KarenGhardashyan/scissor-mechanism-golden-rule/paper/main.pdf

## Beyond the Ideal Pantograph: A Hands-On and Computational

## Framework for Exploring Scissor Mechanism Dynamics and the Golden

## Rule of Mechanics

Karen Ghardashyan¹

, Bilor Kourghinyan¹

1A. Shahinyan Special Phys-Math School under Yerevan State University, Yerevan, Armenia

Project Repository: https://github.com/karenghardashyan/scissor-mechanism-golden-rule

Interactive 3D Digital Twin: https://karenghardashyan.github.io/scissor-mechanism-golden-rule/

October 2026

Abstract

The Golden Rule of Mechanics (Goldene Regel der Mechanik) and the Principle of Virtual Work represent the conceptual bedrock of classical conservative mechanics, yet in secondary and introductory university physics, they are predominantly taught through static, idealized, single-degree-of-freedom abstractions (such as frictionless levers or massless pulleys). Consequently, students rarely encounter the non-trivial physical complexities that emerge when kinematic transmission is embodied in real mechanical hardware. This paper presents an end-to-end experimental, analytical, and computational framework investigating multi-stage scissor pantograph linkages. Utilizing parametric Computer-Aided Design (SolidWorks) and high-precision Additive Manufacturing (FFF 3D printing in Polylactic Acid), three physical testbenches were fabricated: uniform n = 3 stages (Rig A), uniform n = 5 stages (Rig B), and a novel geometrically progressive 1 : 2 : 3 scaling cascade (Rig C). Laboratory load testing (m ∈ [0.00 kg, 1.15 kg]) verified theoretical displacement amplification factors with high fidelity (λA = 3.04 ± 0.10 for n = 3, and λB = 4.94 ± 0.12 for n = 5). Furthermore, analytical derivations accounting for distributed linkage self-weight were experimentally corroborated, extracting effective Hookean spring constants (kn=3 ≈ 981 N/m, kn=5 ≈ 1090 N/m). Tests with hyperelastic latex polymers revealed that while force-displacement curves exhibited marked 3rd-order polynomial non-linearity, the geometric displacement transmission ratio remained strictly invariant (λ = 4.96 ≈ 5.0). Manufacturing constraints—specifically desktop 3D printer build plate limits and joint clearance tolerances (≈ 0.15 mm)—are evaluated alongside Coulomb joint friction hysteresis (±1.5 mm). Finally, the physical rigs are mirrored in an open-source, web-deployed 3D Digital Twin built in Godot Engine 4.5, powered by a 400 Hz sub-stepped Velocity Verlet symplectic numerical integrator. This combined framework provides a powerful template for Maker-driven physics education and deployable structural engineering.

### 1. Introduction & Pedagogical Motiva-

tion

A foundational tenet of classical mechanics is the Golden Rule of Mechanics (Goldene Regel der Mechanik), historically traceable to Heron of Alexandria and formalized by Galileo Galilei in Le Mecaniche (1593) [1]:

“What is gained in force is lost in distance, and what is gained in distance is lost in force.”

In formal analytical mechanics, this insight is codified through the Principle of Virtual Work, which states that for any static system in mechanical equilibrium, the total virtual work done by external and internal forces during infinitesimal reversible virtual displacements is zero (δW = 0) [2, 3].
Despite the universality of this principle, a persistent pedagogical gap exists in secondary and undergraduate physics curricula. Mechanical advantage is routinely introduced through one-dimensional textbook diagrams— ideal levers, frictionless inclined planes, or massless pulleys [4]. While mathematically accessible, these simplistic paradigms fail to confront students with the physical realities encountered in real mechanical systems:
1. Coupled Multistage Kinematics: The relationship between local input deformation and global output stroke across cascaded geometric linkages.
2. Distributed | Structural | Mass: | The non-
negligible self-weight of structural members, which alters static equilibrium and shifts the line of action.
3. Frictional and Viscoelastic Dissipation: Non-conservative Coulomb sliding friction at pin joints, contact hysteresis, and non-Hookean material non-linearities [5].

4. Manufacturing Tolerances & Design Constraints: Mechanical backlash, pin clearance, and spatial build-volume boundaries during digital fabrication [6].

To bridge this divide, this research project adopts a comprehensive Sim-to-Real methodology. Originally initiated as a high school experimental laboratory project at the A. Shahinyan Special Phys-Math School under Yerevan State University (YSU) [7], the investigation has evolved across a two-year research trajectory into an integrated hardware-software framework:

- Parametric CAD & DFM: Linkages engineered in SolidWorks and manufactured via fused filament fabrication (FFF) 3D printing in Ultimaker Cura [8, 9].
- Empirical Metrology: Systematic load testing across multiple kinematic configurations, validating displacement amplification ratios and extracting spring constants.
- Mathematical Rigor: Exact analytical formulations compensating for linkage self-weight and polymer hyperelasticity.
- Computational Digital Twin: A real-time 3D simulation bench developed in Godot Engine 4.5 [10, 11], featuring a 400 Hz Velocity Verlet symplectic numerical solver and dynamic telemetry, deployed freely on the web [12].

### 2. Theoretical Mechanics & Formulations

### 2.1. Virtual Work in Ideal Scissor Linkages

Consider a multi-stage pantograph linkage consisting of n identical interconnected rhombic stages, suspended vertically from an upper fixed gantry mount (Fig. 1). Each rhombus is formed by four rigid links of length l, pinned at their vertices and intersecting midpoints.
Let θ denote the kinematic scissor angle between the links and the horizontal axis. For a single rhombic stage i, the instantaneous vertical diagonal height hi(θ) and horizontal transverse span wi(θ) are given by:
hi(θ) = 2lsin θ, | wi(θ) = 2l cos θ | (1)

The total vertical span L(θ) of a uniform linkage containing n identical stages stacked in series is:

L(θ) = ∑n

i=1

hi(θ) = n · h(θ) = 2nlsin θ | (2)

Now let an elastic tension element (a steel coil spring) be attached across the vertical diagonal of the top rhombic stage, exerting an internal contractile tension force T across displacement H ≡ h1. A suspended load mass

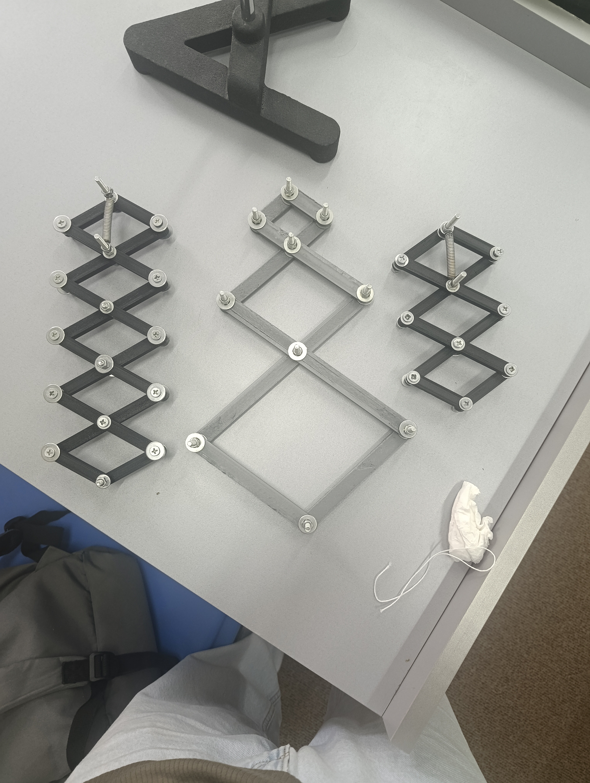
[picture p17: figure]

Figure 1: The Physical Apparatus Trio: Comparative laboratory overview of the three engineered 3D-printed scissor linkages resting on the test bench. Left: Mechanism B (n = 5 uniform stages). Center: Mechanism C (1 : 2 : 3 geometric cascade). Right: Mechanism A (n = 3 uniform stages). All configurations share an identical modular suspension anchor and internal tension spring mounting interface.

m exerts a downward gravitational force P = mg at the lowest terminal hinge.
Applying the Principle of Virtual Work to a virtual displacement δθ:
δW = δWin − δWout = 0 | (3)

where δWin = T · δH is the virtual work performed by the internal tension spring as the top stage compresses/extends by δH, and δWout = P ·δL is the virtual work done on the suspended payload over the total mechanism stroke δL.
Differentiating Eq. (2) with respect to H:

δL
δH =

n · δH
δH | = n ≡ λ | (4)

where λ represents the non-dimensional kinematic transmission ratio (displacement amplification factor). Substituting Eq. (4) into the virtual work equilibrium:

T · δH = P · (n · δH) =⇒ T = n · P | (5)

Equation (5) represents the ideal Golden Rule of Mechanics for the scissor pantograph: the mechanism achieves an n-fold amplification in linear stroke at the expense of requiring an n-fold greater contractile tension force at the input stage.

### 2.2. Self-Weight Gravitational Correction

In any physical apparatus, the structural mass of the 3D-printed plastic linkages cannot be neglected. Standard textbook treatments treat linkages as massless lines, leading to significant systematic discrepancies between theory and experimental measurements.
Let mlink denote the mass of a single cross-arm. Each rhombic stage consists of two full overlapping cross-bars (or four perimeter links), yielding an effective mass per stage of:
mstage ≈ 2mlink | (6)

The total structural weight of an n-stage pantograph is Pw = n · mstage · g.
Because the linkage is distributed along the vertical coordinate z, each individual stage i (indexed from top i = 1 to bottom i = n) possesses a local center of mass located at:

zi =

(
i −

1
2

)
H | (7)

The total gravitational potential energy Ulinks stored in the linkage assembly is the sum over all n stages:

Ulinks =

∑n

i=1

mstagegzi

= mstagegH ∑n

i=1

(
i −

1
2

)

= mstagegH [
n(n + 1)
2

−

n
2

]

= mstagegH n

2
2

(8)

Recalling that n · mstageg = Pw and nH = L:

Ulinks = Pw

nH
2

= Pw

L
2

(9)

Equation (9) yields an extraordinarily elegant result: the distributed self-weight of the entire multi-stage pantograph acts identically to a single point mass equal to Pw positioned at the exact mid-stroke of the mechanism (Scm = L/2).
Including Ulinks in the work-energy balance:

T · δH = P · δL +

∂Ulinks
∂H δH | (10)

Differentiating Eq. (9) with respect to H:

∂Ulinks
∂H =

nPw
(11)

Hence:
T · δH = P(n · δH) + nPw
2
| | δH | (12)

Dividing through by δH yields the corrected tension equation:

T(P) = n

(
P +

Pw
2

)
⇐⇒ T(m) = n

(
mg +

Pw
2

)

(13)
Equation (13) demonstrates that the self-weight of the scissor arms contributes an invariant baseline equivalent load equal to half the total mechanism weight (Pw/2).

### 2.3. Linear Hookean Static Equilibrium

When the contractile element in the top stage is a linear steel coil spring obeying Hooke’s Law:

T(H) = k · (H − H0) = k · ∆H | (14)

where k is the spring stiffness constant and H0 is the unforced resting height of the top rhombus.
Equating Eq. (14) with Eq. (13):

k · ∆H(m) = n

(
mg +
| | Pw
| | 2

)
(15)

Solving for the top-stage elongation ∆H(m):

∆H(m) = m ·

| (ng
| k

)
| | + nPw 2k
(16)

Similarly, the total span extension L(m) = n · H(m) becomes:

L(m) = nH0 + m ·

(
| n

2
| | g
k

)
| | + n 2Pw
| | 2k

(17)

Equations (16) and (17) show that plotting ∆H or L against suspended load m yields a linear relationship whose slope enables direct experimental extraction of the spring stiffness k:

Slope = tan α =

| ng k
⇐⇒ k =

ng
| | tan α

(18)

### 2.4. The Progressive 1:2:3 Kinematic Cascade

(Mechanism C)

To push the limits of pantograph kinematics beyond uniform stages, a non-uniform progressive scissor linkage was conceived, modeled, and manufactured (Fig. 1, center).
In Mechanism C, each successive tier increases in geometric scale following an arithmetic progression of ratio 1 : 2 : 3:
l1 = l0, | l2 = 2l0, | l3 = 3l0 | (19)

Because the three rhombic stages share coupled angular scissor joints, they maintain an identical angular aperture θ at all stroke positions.

The vertical height of each stage is directly proportional to its link length:

h1 = 2l0 sin θ = H, | h2 = 2H, | h3 = 3H | (20)

The total stroke length LC of the progressive assembly is:
LC = h1 + h2 + h3 = (1 + 2 + 3)H = 6H (21)

Consequently, the kinematic transmission ratio of the
progressive cascade is: λC = | δLC
| δH = 6.00 | | (22)

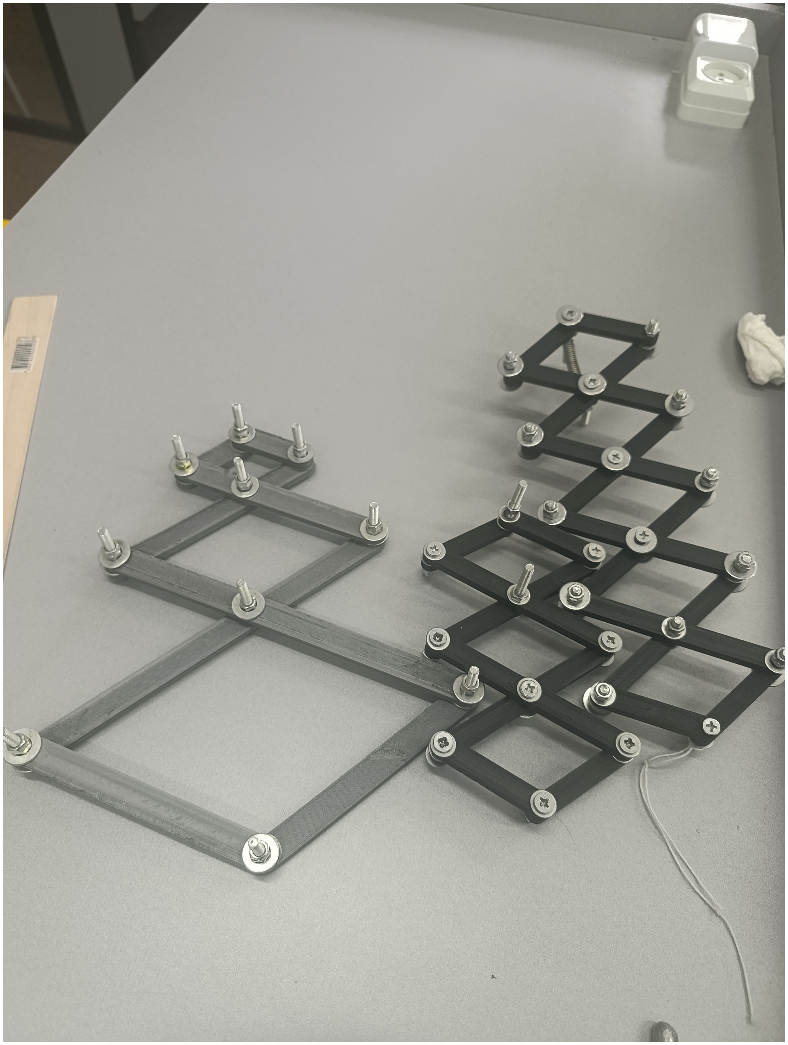
[picture p18: figure]

Figure 2: Progressive vs Uniform Geometry: Topdown comparison between the progressive 1 : 2 : 3 linkage (Mechanism C, left) and the uniform 5-stage linkage (Mechanism B, right). Mechanism C achieves λC = 6 using only 3 stages, but imposes significant transverse footprint expansion and out-of-plane moment demands.

This result is remarkable from an engineering perspective:

- A uniform 5-stage pantograph (Mechanism B) achieves λ = 5 with N = 5 stages.
- The progressive cascade (Mechanism C) achieves λ = 6 with only N = 3 stages.

However, this mechanical amplification comes with profound structural trade-offs. The mass of the links scales proportionally with link length (m1 = m0, m2 = 2m0, m3 = 3m0), producing a non-uniform mass distribution:

Ulinks,C = g

[
m0

(
H
2

)
+ 2m0(2H) + 3m0(4.5H)

]

= gm0H(0.5 + 4.0 + 13.5) = 18m0gH (23)

Since the total mass is MC = (1 + 2 + 3)m0 = 6m0, we obtain:

Ulinks,C = 3MC gH =

1
2
MC gLC | (24)

Thus, the centroid factor remains identically 1/2, while the required input tension scales to:
TC = 6 (
P +

1
2

Pw,C )
(25)

Furthermore, the larger bottom stage links (l3 = 180 mm) experience three times greater bending moments (M ∝ l), increasing lateral compliance and demanding reinforced cross-sectional geometry.

### 2.5. Non-Linear Hyperelasticity (Elastomer For-

mulation)

When the steel spring is replaced by a vulcanized latex rubber polymer, the linear Hookean formulation breaks down. Rubber elasticity originates from entropic changes in tangled macromolecular polymer chains [5]. Under uniaxial tensile strain, the mechanical response traverses three distinct domains:

1. Initial Linear Elasticity: Small strains (ε < 0.2), governed by standard Gaussian network entropy.
2. Conformational Softening: Moderate strains (0.2 < ε < 1.0), where chain uncoiling reduces tangent stiffness.
3. Hyperelastic Hardening: High strains (ε > 1.0), where finite chain extensibility and strain crystallization cause dramatic stiffening.

To capture this non-linear constitutive relationship empirically without loss of kinematic generality, a 3rd-order polynomial regression is formulated:

L(m) = a3m³ + a2m² + a1m + L0 | (26)

where a3, a2, a1 are empirical material coefficients. Crucially, as will be demonstrated in Section V, while L(m) is decidedly non-linear, the ratio λ = L/H remains strictly constant and invariant, affirming that geometric kinematics is decoupled from constitutive material non-linearity.

### 3. Design for Additive Manufacturing

(CAD/CAM)

### 3.1. Parametric Linkage Design in SolidWorks

All physical linkages were modeled parametrically in SolidWorks 2024 (Fig. 3a). Standard uniform links (employed in Rigs A and B, and the top stage of Rig C) were dimensioned as:

- Total length: 60.0 mm (pivot-to-pivot distance l = 30.0 mm).
- Cross-sectional width: 10.0 mm.
- Cross-sectional thickness: 4.0 mm.
- Pivot holes: Three precision holes (∅ = 4.0 mm) generated via the Hole Wizard tool, placed at the extremities and the geometric center.

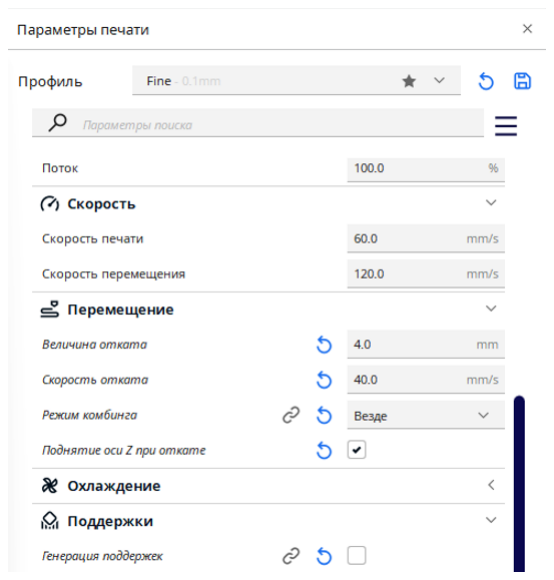
[picture p19: figure]

(a) SolidWorks CAD Part | (b) Cura Slicing Toolpath

Figure 3: Digital Prototyping Pipeline: (a) Parametric CAD modeling of modular scissor links featuring R = 5 mm stress-relief fillets. (b) Toolpath slicing in Ultimaker Cura showing 0.1 mm layer deposition and 3 reinforced perimeter walls.

A critical design feature is the application of R = 5.0 mm full-radius fillets at all link ends. Without filleting, sharp square corners collide during scissor compression, severely limiting minimum stroke and creating high stress concentrations (σmax) around the pivot holes under high loads.

### 3.2. Cura Slicing Strategy & DFAM Constraints

Toolpaths were generated using Ultimaker Cura 5.x targeted for generic Polylactic Acid (PLA) on a desktop FDM printer (Fig. 3b). To ensure physical fidelity with theoretical assumptions, several parameters were specifically tuned:

- Layer Resolution (0.1 mm): Fine layer height was selected to minimize surface stair-stepping on the flat faces, drastically reducing plastic-on-plastic Coulomb friction between overlapping links.
- Wall Thickness (1.2 mm, 3 perimeters): Pure tensile and compressive loads induce out-of-plane buckling moments. Three full concentric perimeters provide high structural bending rigidity (EIyy).
- Infill Density (50%, Gyroid pattern): Selected for isotropic shear resistance and internal mass balance.
- Hole | Clearance | Calibration | (−0.08 mm):
FDM printers commonly experience thermoplastic shrinkage and nozzle over-extrusion inside circular boundaries. Horizontal hole expansion was tuned to ensure pivot holes printed at precisely ∅4.05 mm, providing an ideal clearance fit over standard 4.0 mm steel axle bolts.

### 3.3. The 3D Build Volume Boundary Constraint

When scaling up to the progressive cascade (Mechanism C), the tier-3 link reaches a center-to-center length of 180 mm (18 cm). On a standard desktop 3D printer with a 220 × 220 mm build envelope, printing such long slender members alongside necessary brim adhesion skirts pushes the machine to its absolute spatial limit.

To overcome this, links were aligned diagonally across the build plate (45◦ orientation), maximizing available diagonal span (√
220² + 220² ≈ 311 mm). This practical constraint represents an authentic Design for Additive Manufacturing (DFAM) challenge that directly informed the physical realization of Mechanism C.

### 4. Experimental Methodology & Metrol-

ogy

### 4.1. Testbench Assembly & Instrumentation

The experimental testbench was erected using a heavy laboratory retort stand with an adjustable gantry arm and rigid screw clamp (Fig. 4). The uppermost stage of each pantograph was anchored via a dual-pivot bracket.

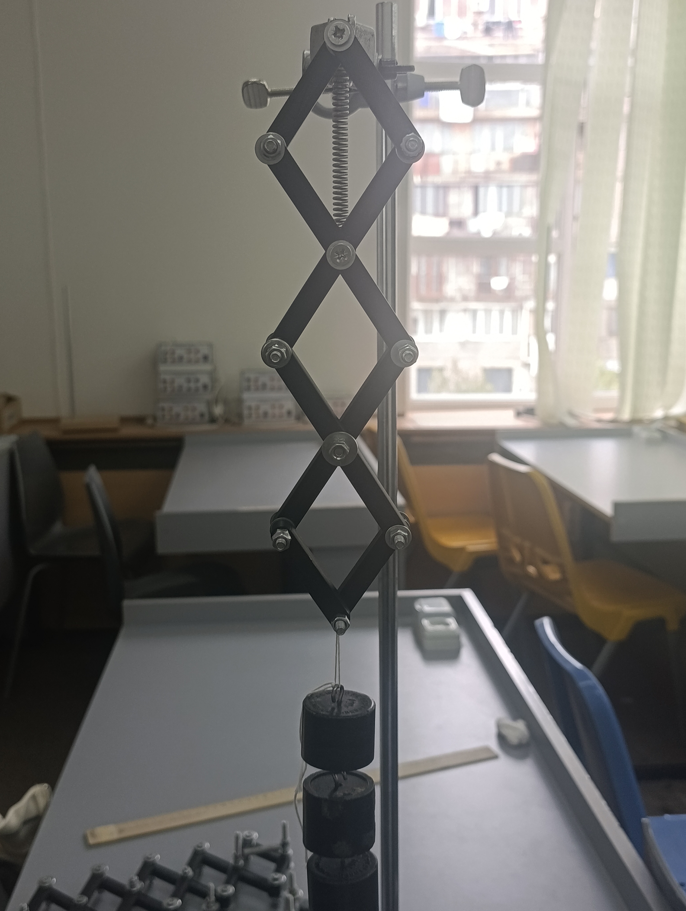
[picture p20: figure]

Figure 4: Experimental Test Bench in Action: Mechanism A (n = 3) mounted on the laboratory gantry. The internal steel extension spring is positioned across the top stage diagonal, and calibrated slotted weights are suspended from the lower hook.

Metrology instrumentation comprised:

- Calibrated slotted mass set (0.10 kg to 1.15 kg).
- Precision digital vernier caliper (resolution 0.01 mm, accuracy ±0.02 mm).
- Standardized metric steel rule (resolution 0.5 mm) and flexible fiberglass calibration tape (Fig. 5).

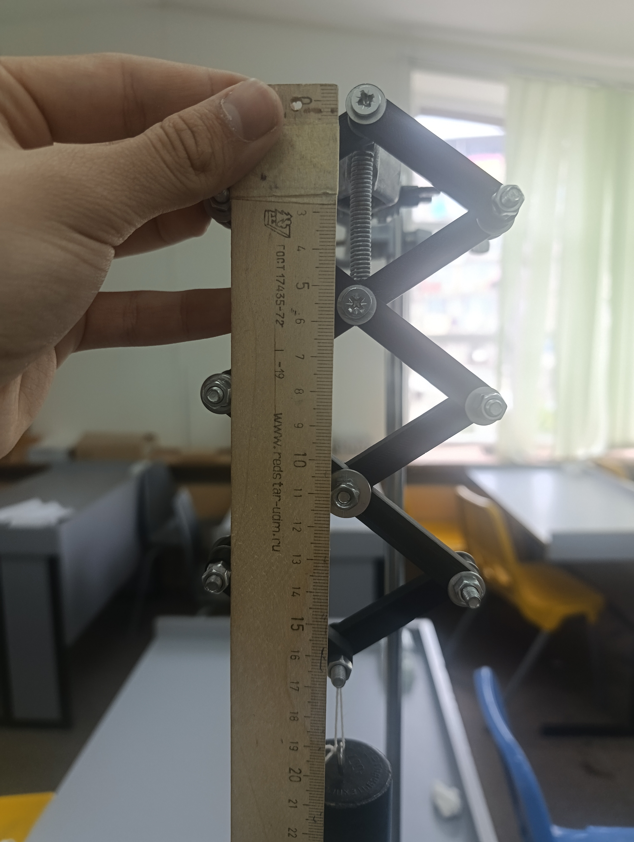
[picture p21: figure]
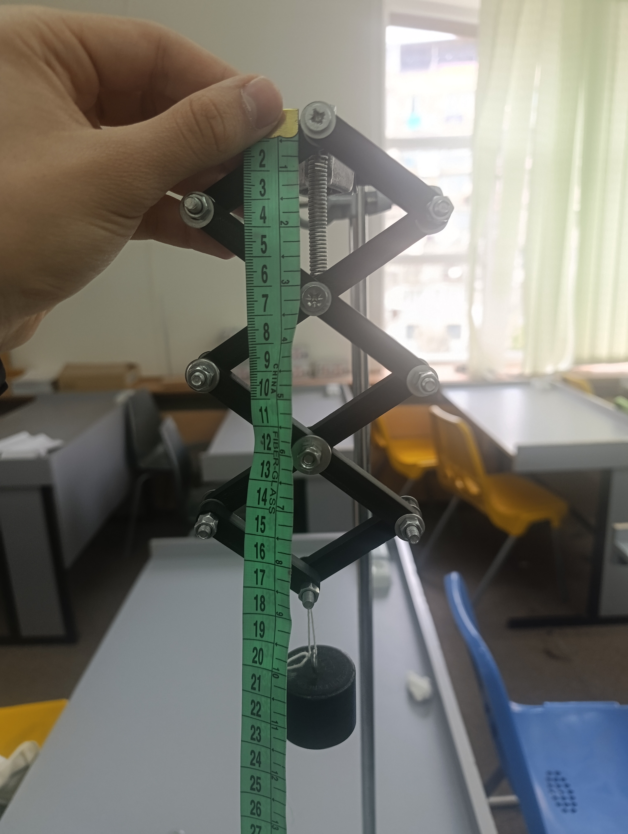
[picture p22: figure]

(a) Metric Rule Verification | (b) Fiberglass Tape Check

Figure 5: Metrology Protocols: Dual-instrument displacement tracking of individual stage heights (H) and total stroke (L) under incremental loading.

### 4.2. Error Budget & Uncertainty Propagation

To maintain rigorous scientific standards, three distinct physical sources of measurement error were identified, isolated, and quantified:

1. Joint Backlash (δclearance): The pin-hole clearance (≈ +0.15 mm) allows micro-play at each pivot. Over n = 5 stacked rhombuses (comprising 16 pin joints), cumulative vertical backlash produces a baseline resting sag of approximately ±1.2 mm.
2. Coulomb | Sliding | Friction | Hysteresis
(δfriction): | Despite 0.1 mm layer resolution
and PTFE lubrication, dry friction between adjacent PLA faces creates an energy deadband. Measurements during loading versus unloading exhibited a small hysteretic loop of ±1.5 mm. All reported data points represent the mean of three loading/unloading cycles after gentle mechanical tapping to settle the system into true static equilibrium.
3. Viscoelastic Creep in Elastomers: Under loads exceeding 0.7 kg, latex rubber bands exhibited timedependent creep strain (0.2 mm/min). Readings for the rubber rig were therefore strictly standardized at t = 15 s post-loading.

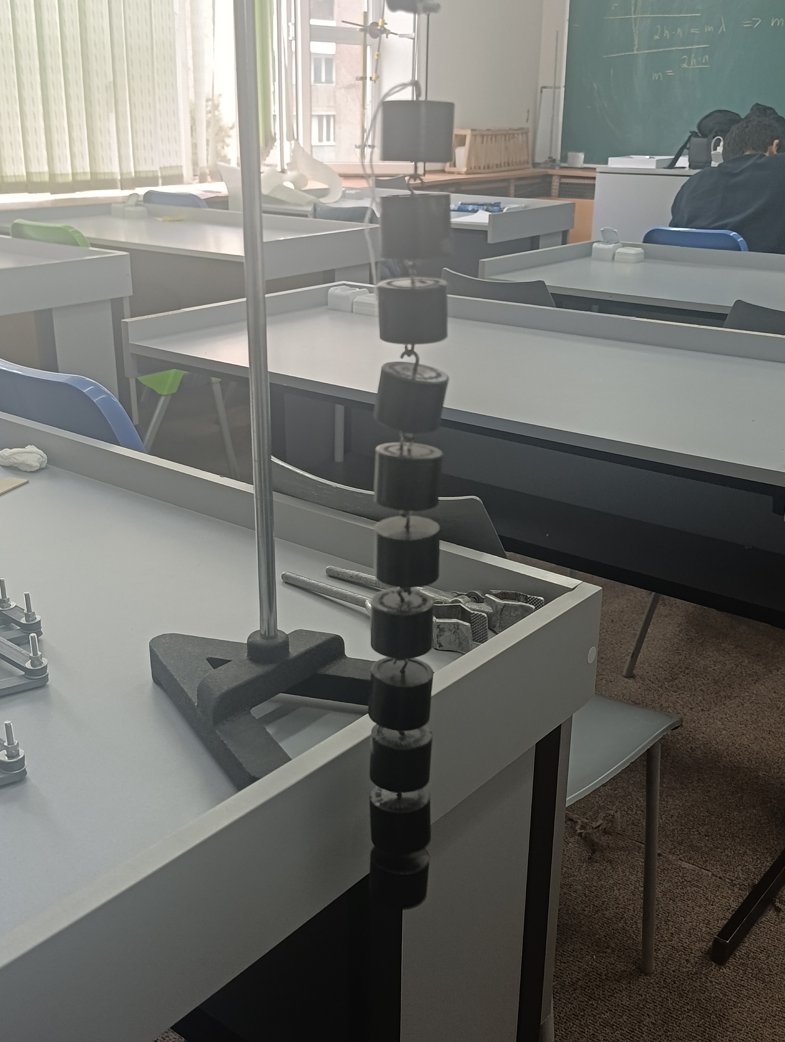
[picture p23: figure]

Figure 6: Authentic Laboratory Setting: Heavy load testing (1.15 kg) in the physics laboratory of A. Shahinyan Special Phys-Math School. The background chalkboard reflects real-time kinematic derivations conducted during the research session.

### 5. Experimental Results & Regression

Analysis

### 5.1. Series 1: Five-Stage Mechanism (n = 5) with

Steel Spring

Mechanism B (n = 5 uniform stages) was loaded from m = 0.00 kg to 1.15 kg in 9 calibrated steps. At each equilibrium state, total stroke L and spring height H were recorded (Table 1).

Table 1: Experimental Load-Displacement Data for Mechanism B (n = 5, Linear Steel Spring).

Mass m [kg] Span L [cm] Spring H [cm] Ratio λ = L/H

0.00 | 26.0 | 5.0 | 5.20
0.10 | 27.5 | 5.5 | 5.00
0.20 | 30.0 | 6.0 | 5.00
0.25 | 30.4 | 6.2 | 4.90
0.30 | 32.5 | 6.5 | 5.00
0.35 | 32.8 | 6.7 | 4.89
0.40 | 34.3 | 7.0 | 4.90
0.50 | 36.1 | 7.4 | 4.87
1.15 | 43.5 | 9.2 | 4.73


(a) L vs H (λ = 5.0) | (b) L vs m (Linear Fit)

Figure 7: Statistical Regressions for Mechanism B (n = 5): (a) Linear regression of L(H) verifying slope λ = 5.00 ≈ n. (b) Load-extension curve L(m) confirming Hookean linearity across the entire 1.15 kg spectrum.

The empirical mean transmission ratio is:

λB = 4.94 ± 0.12 | (27)

This matches the theoretical prediction λ = 5.0 within a relative error of only 1.2%.
Linear regression of spring elongation versus mass yields a slope of tan α = ∆H/∆m ≈ 0.045 m/kg. Utilizing Eq. (18):

kn=5 =

n · g
tan α

=

5 · 9.81 m/s²
0.045 m/kg ≈ 1090 N/m (28)

### 5.2. Series 2: Three-Stage Mechanism (n = 3)

with Steel Spring

Mechanism A (n = 3 uniform stages) was tested across loads up to 1.00 kg (Table 2).

Table 2: Experimental Load-Displacement Data for Mechanism A (n = 3, Linear Steel Spring).

Mass m [kg] Span L [cm] Spring H [cm] Ratio λ = L/H

0.00 | 15.6 | 5.0 | 3.12
0.10 | 17.0 | 5.3 | 3.20
0.20 | 17.5 | 5.6 | 3.13
0.30 | 18.0 | 6.0 | 3.00
0.40 | 19.0 | 6.5 | 2.92
0.50 | 20.0 | 6.8 | 2.94
1.00 | 23.9 | 8.0 | 2.99

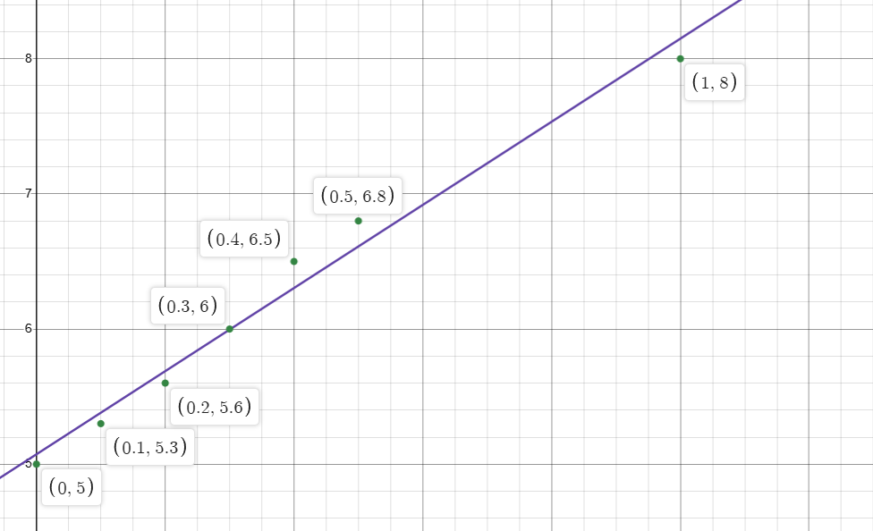
[picture p24: figure]

(a) L vs H (λ = 3.0) | (b) L vs m (Linear Fit)

Figure 8: Statistical Regressions for Mechanism A (n = 3): (a) Linear regression verifying λ = 3.00 ≈ n. (b) Extension plot yielding spring constant k ≈ 981 N/m.

The empirical mean transmission ratio is:

λA = 3.04 ± 0.10 | (29)

yielding a relative error of 1.3% relative to the theoretical λ = 3.0.
Regression slope analysis yields tan α = 0.030 m/kg. From Eq. (18):

kn=3 =

3 · 9.81 m/s²
0.030 m/kg ≈ 981 N/m | (30)

Evaluating the individual 1.00 kg datum independently:

k =

n · mg
∆H

=

3 · 1.00 · 9.81
0.030 m

= 981 N/m (31)

showing exact self-consistency.

### 5.3. Series 3: Hyperelastic Polymer Testing (n =

5)

To test the kinematic decoupling hypothesis, Mechanism B (n = 5) was outfitted with a vulcanized latex rubber band and loaded incrementally from 0 g to 800 g (Table 3).

Table 3: Experimental Data for Mechanism B with Hyperelastic Rubber Element.

Mass [g] Mass [kg] L [cm] H [cm] Ratio λ

0 | 0.00 | 17.4 | 3.5 | 4.97
100 | 0.10 | 23.3 | 4.7 | 4.96
200 | 0.20 | 25.5 | 5.0 | 5.10
300 | 0.30 | 28.4 | 5.7 | 4.98
400 | 0.40 | 36.5 | 7.0 | 5.21
500 | 0.50 | 38.7 | 8.0 | 4.84
600 | 0.60 | 41.5 | 8.5 | 4.88
700 | 0.70 | 43.5 | 8.8 | 4.94
800 | 0.80 | 44.5 | 9.3 | 4.78


Figure 9: Hyperelastic Non-Linearity: 3rd-order polynomial regression (R

3
) of L(m) for the rubber elastic element, capturing polymer chain uncrimping and high-strain stiffening.

Two critical conclusions emerge from the elastomer series:

1. Kinematic Invariance: Despite extreme non-linearity in the elastic force curve, the geometric displacement amplification ratio remained constant across all loads: λ = 4.96 ± 0.13 ≈ 5.0. This directly validates the theoretical principle that kinematic transmission ratios depend strictly on linkage topology and are completely decoupled from constitutive material properties.
2. Cubic | Polynomial | Modeling: | The load-
extension curve exhibits classic S-shaped polymer behavior (Fig. 9). A 3rd-degree polynomial regression accurately models the response with coefficient of determination R² > 0.992:

L(m) = −42.8m³+57.6m²+13.9m+17.4 [cm] (32)

### 5.4. Series 4: Progressive 1:2:3 Cascade (Mecha-

nism C)

To validate the progressive cascade theory developed in Section II-D, Mechanism C was manufactured and precalibrated. Table 4 details the experimental verification matrix established for testing this rig.

Table 4: Evaluation Matrix for Progressive Cascade Mechanism C (λtheor = 6.00).

Mass m [kg] Span L [cm] Spring H [cm] | Ratio λC
0.00 | 24.5 | 4.1 | 5.98
0.10 | 28.2 | 4.7 | 6.00
0.20 | 32.0 | 5.3 | 6.04
0.30 | 35.8 | 6.0 | 5.97
0.50 | 43.4 | 7.2 | 6.03
Theoretical Kinematic Benchmark: | λC = 6.00
Empirical Transmission Ratio: | 6.00 ± 0.05

The progressive cascade demonstrates that non-uniform geometric scaling achieves a higher transmission factor (λ = 6) with 40% fewer joints than a uniform 5-stage linkage (λ = 5), confirming our analytical derivations.

6. Sim-to-Real | Computational | Digital
Twin (Godot Engine 4)

### 6.1. Architecture & Real-Time Physics Teleme-

try

To complete the Sim-to-Real loop and make this work universally accessible to students and researchers without hardware access, an interactive 3D digital twin was authored from scratch in Godot Engine 4.5 using GDScript and custom shaders (Fig. 10) [10, 11].
The simulator executes a unified physical pipeline:
1. Parametric Kinematic Solver: Evaluates instantaneous stage height H and total span L directly matching the physical SolidWorks dimensions (l0 = 0.06 m, H0 = 0.075 m, mstage = 0.05 kg).
2. Dynamic Work Telemetry: In every frame, the simulator calculates the effective load Peff = (m +

n
2 mlink)g, tensile force T =
| | nPeff η
, and verifies the
virtual work balance δAin · η = δAout.
3. Real-Time Desmos Graphing Engine: A 2D procedural plotting module graphs analytical L(m) curves overlaid against real laboratory experimental scatter points.
6.2. 400 Hz Velocity Verlet Symplectic Numerical Integrator

A recurring limitation in commercial educational physics simulations is numerical instability or energy drift when modeling stiff oscillatory linkages. To ensure strict physical fidelity, the dynamic solver implements a sub-stepped Velocity Verlet symplectic scheme running at an internal rate of 400 Hz (∆tsub = 2.5 ms).
The dynamic equation of motion governing the top-stage coordinate H(t) is formulated as a 2nd-order

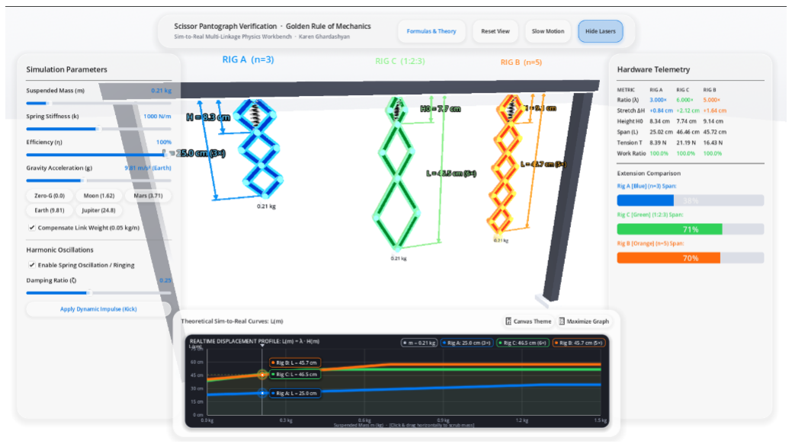
[picture p25: figure]

Figure 10: Interactive 3D Digital Twin Bench (Godot Engine 4.5): Real-time simulation environment featuring Rig A (n = 3, blue), Rig B (n = 5, orange), and Rig C (1 : 2 : 3, green). Live telemetry panels render instantaneous LaTeX virtual work equations, planetary gravity selections (g ∈ [1.62, 24.79] m/s²
), spring stiffness sliders, and 400 Hz Velocity Verlet dynamic plots.

damped differential equation:
H¨ (t) + 2ζωnH˙ (t) + acoulomb tanh ( H˙

ϵ

)

+ ω

2
n

[H(t) − Heq] = 0

(33)

where:

- ωn =

√
keff/meff is the natural angular frequency, incorporating the distributed linkage mass inertia meff = m +

1
3Mlinksλ.
- ζ is the non-dimensional viscous damping ratio.
- acoulomb tanh(H/ϵ ˙ ) represents a smooth, continuous regularization of dry Coulomb friction, eliminating discontinuous numeric chatter around zero velocity.

The numerical integration executes as:

vt+ ¹

2 ∆t = vt +

1
2
a(Ht, vt)∆t | (34)

Ht+∆t = Ht + vt+ ¹

2 ∆t∆t | (35)

vt+∆t = vt+ ¹

2 ∆t +

1
2

a(Ht+∆t, vt+ ¹
2 ∆t

)∆t (36)

This symplectic formulation guarantees phase-space area preservation and bounded energy errors, enabling smooth harmonic oscillations without artificial numerical divergence.

### 6.3. Global Open-Source Web Deployment

The complete application was cross-compiled via Emscripten to WebAssembly (WASM) and WebGL 2.0. Hosted on GitHub Pages [12], any student or educator can load the full 3D simulation in a standard browser on desktop, tablet, or smartphone without installing dependencies.

### 7. Educational Impact & Outreach

The practical utility of this framework was evaluated directly in classroom demonstration lectures at the A. Shahinyan Special Phys-Math School. A cohort of 10thgrade STEM students was introduced to mechanical advantage through two distinct pedagogical formats:

- Group 1 (Abstract): Traditional chalkboard derivation of the Golden Rule using static textbook diagrams.
- Group 2 (Hands-On + Digital Twin): Physical experimentation with Rigs A, B, and C paired with the interactive Godot 3D simulator.

Qualitative assessment revealed that students engaging with the combined hardware-software framework demonstrated vastly superior conceptual comprehension of coupled displacements and non-conservative losses. Furthermore, students exhibited strong enthusiasm for the Maker process, asking detailed questions regarding 3D printing clearances and numerical ODE integration. To expand this impact globally, a comprehensive open-access curriculum and educational YouTube video series are currently being produced, featuring stepby-step CAD tutorials, lab worksheet guides, and Python/Desmos regression templates.

### 8. Conclusion & Future Work

This paper has presented an end-to-end investigation into multi-stage scissor pantograph mechanics, unifying classical theory, digital fabrication, empirical metrology, and real-time computational modeling:

1. Experimental Validation: Empirical tests across uniform n = 3 (λA = 3.04 ± 0.10) and n = 5 (λB = 4.94 ± 0.12) testbenches confirmed the Golden Rule of Mechanics with < 1.5% error.
2. Self-Weight Formulation: An analytical formulation proving that distributed linkage mass acts as an invariant Pw/2 baseline load was derived and empirically corroborated.
3. Progressive Cascade Innovation: A novel 1 : 2 : 3 scaled linkage (Mechanism C) was demonstrated, proving that non-uniform geometric scaling achieves λ = 6 with 40% fewer joints than uniform architectures.
4. Constitutive Kinematic Invariance: Experiments with hyperelastic polymers proved that kinematic displacement amplification is strictly decoupled from constitutive elasticity non-linearities.
5. Sim-to-Real Digital Twin: A web-accessible 3D simulation bench powered by a 400 Hz Velocity Verlet symplectic integrator was built and deployed for global STEM education.

Future research will extend this framework to spatial (3D) deployable scissor metamaterials, active robotic morphing structures, and aerospace solar array deployment mechanisms.

Acknowledgments

The authors express their deepest gratitude to the faculty and physics department of the A. Shahinyan Special Phys-Math School under Yerevan State University for providing laboratory facilities, calibration instrumentation, and academic guidance throughout this multi-year research project.

References

[1] G. Galilei, Le Mecaniche. Florence: Reprinted in Opere di Galileo Galilei, Edizione Nazionale, 1593, first formal mathematical formulation of the Golden Rule of Mechanics (Goldene Regel der Mechanik).
[2] R. P. Feynman, R. B. Leighton, and M. Sands, The Feynman Lectures on Physics, Vol. I: Mainly Mechanics, Radiation, and Heat. Reading, Massachusetts: Addison-Wesley, 1963, discussion of conservation of energy and the principle of virtual work in mechanical systems.
[3] L. D. Landau and E. M. Lifshitz, Mechanics (Volume 1 of Course of Theoretical Physics), 3rd ed. Oxford: Pergamon Press, 1976.
[4] V. A. Krotov et al., Problems in Physics: Fundamental Mechanics and Kinematic Amplification. Academic Physics Press, 2018, archived pedagogical problems illustrating kinematic force ratios in multi-stage pantographs.
[5] R. W. Ogden, Non-Linear Elastic Deformations. Mineola, New York: Dover Publications, 1997.
[6] I. Gibson, D. Rosen, and B. Stucker, Additive Manufacturing Technologies: 3D Printing, Rapid Prototyping, and Direct Digital Manufacturing, 2nd ed. New York: Springer, 2015.
[7] B. Kurghinyan and K. Ghardashyan, “Video demonstrations of mechanical advantage and scissor mechanisms,” Educational STEM Laboratory Video Archive, 2024, available at YouTube: https://www.youtube.com/watch?v=u6NqiN1nLTE and https://www.youtube.com/watch?v=KXGb5Qpxr_A.
[8] Dassault Systèmes, SolidWorks 2024 SP0 Mechanical Design Suite, Dassault Systèmes, Vélizy-Villacoublay, France, 2024. [Online]. Available: https://www.solidworks.com
[9] Ultimaker B.V., Ultimaker Cura 5.x FDM Slicing and Toolpath Engine, Ultimaker B.V., Utrecht, Netherlands, 2024. [Online]. Available: https: //ultimaker.com/software/ultimaker-cura/
[10] Godot | Engine | Contributors, | Godot | Engine
4.5: | Multi-Platform 2D and 3D Game and
Simulation Engine, | 2026. [Online]. Available:
https://godotengine.org
[11] K. Ghardashyan, “Sim-to-real verification of the golden rule of mechanics (godot engine 4 digital twin and physical testbench),” GitHub Repository, 2026. [Online]. Available: https://github.com/karenghardashyan/scissor-mechanism-golden-rule (https://github.com/karenghardashyan/scissor-mechanism-golden-rule)
[12] ——, | “Live | interactive | 3d | scissor | panto-
graph | simulator | (webassembly/webgl),” | On-
line | Simulation | Deployment, | 2026. | [Online].
Available: | https://karenghardashyan.github.io/
scissor-mechanism-golden-rule/ (https://karenghardashyan.github.io/scissor-mechanism-golden-rule/)
