KarenGhardashyan/scissor-mechanism-golden-rule/cad/screenshots/Снимок экрана (4).png

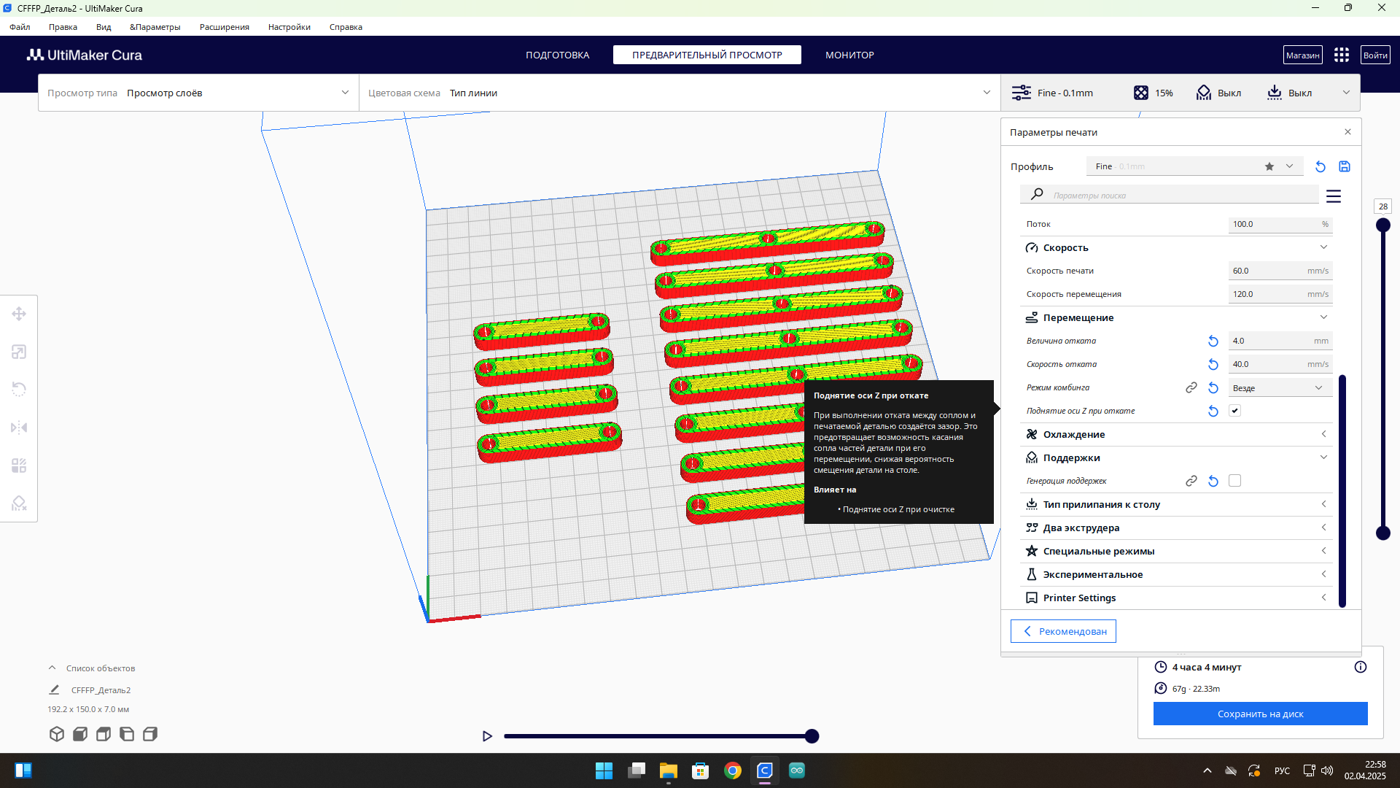
cad/screenshots/Снимок экрана (4).png
