KarenGhardashyan/scissor-mechanism-golden-rule/cad/screenshots/Снимок экрана (5).png

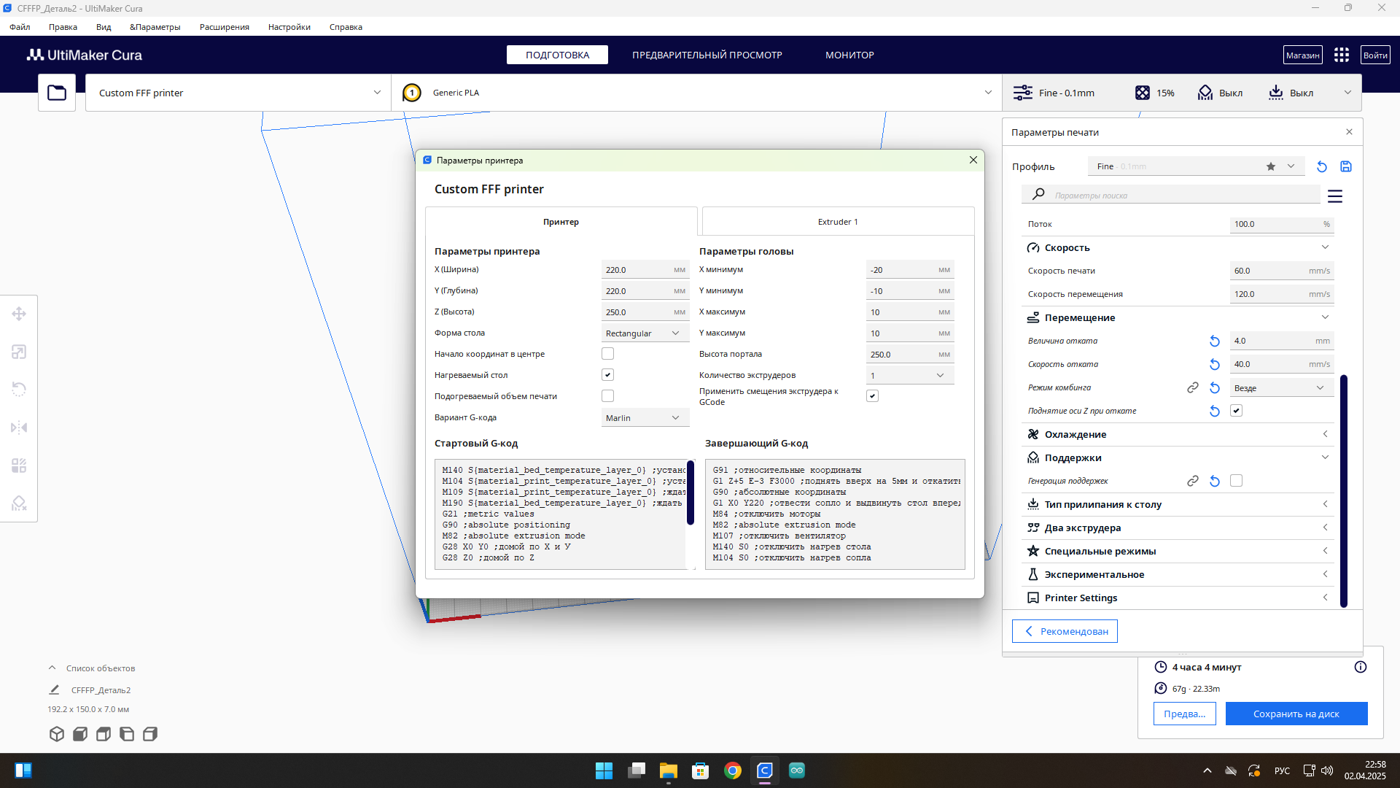
cad/screenshots/Снимок экрана (5).png
