KarenGhardashyan/scissor-mechanism-golden-rule/cad/screenshots/Снимок экрана (6).png

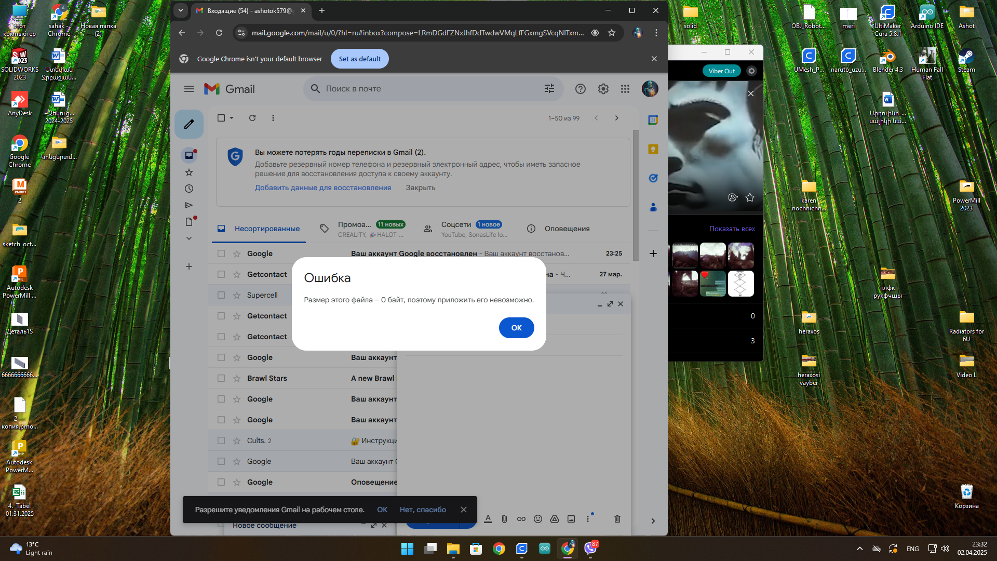
cad/screenshots/Снимок экрана (6).png
