KarenGhardashyan/scissor-mechanism-golden-rule/docs/images/hardware/media_1791_p1_img0.png

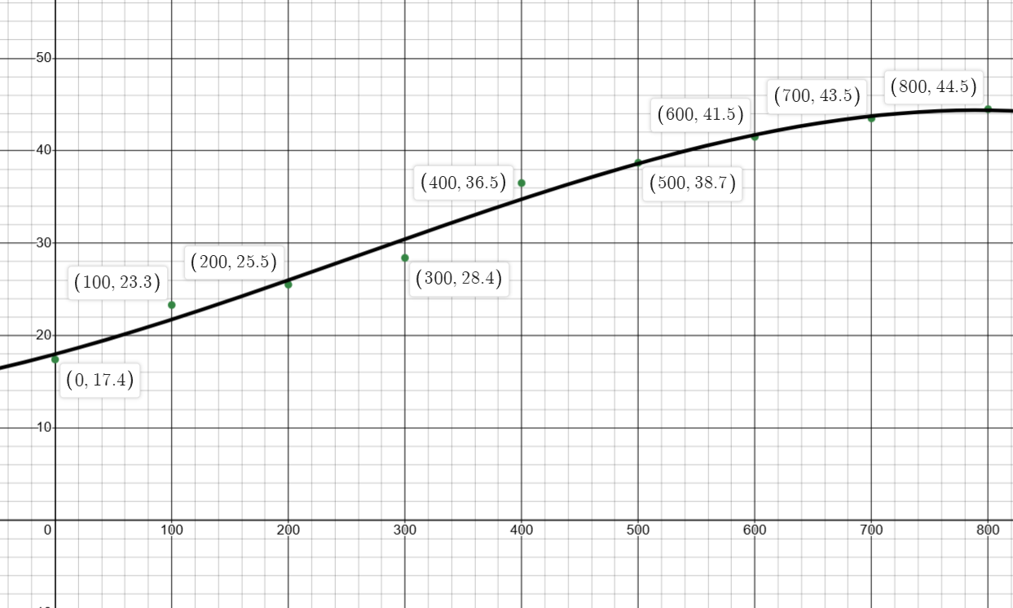
docs/images/hardware/media_1791_p1_img0.png
