KarenGhardashyan/scissor-mechanism-golden-rule/paper/figures/fig_cura_gcode.png

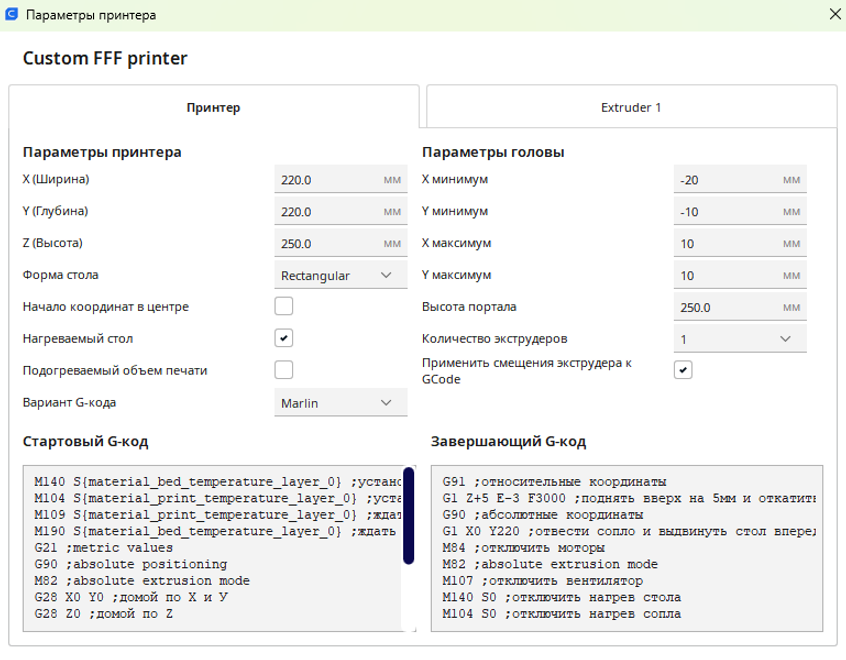
paper/figures/fig_cura_gcode.png
