KarenGhardashyan/scissor-mechanism-golden-rule/paper/figures/fig_rig_a_heavy_load.jpg

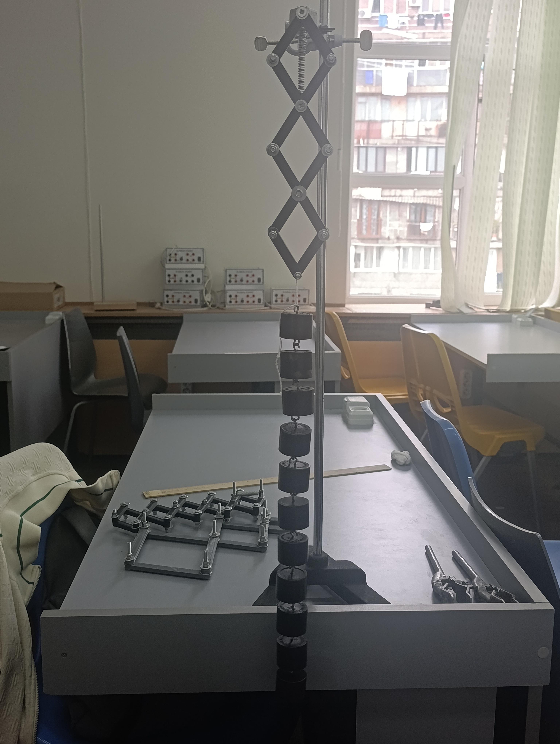
paper/figures/fig_rig_a_heavy_load.jpg
