KarenGhardashyan/scissor-mechanism-golden-rule/cad/gcode/skizb/M140 S{material_bed_temperature_lay.txt

M140 S{material_bed_temperature_layer_0} ;установить температуру стола
M104 S{material_print_temperature_layer_0} ;установить температуру сопла
M109 S{material_print_temperature_layer_0} ;ждать достижения температуры сопла
M190 S{material_bed_temperature_layer_0} ;ждать достижения температуры стола
G21 ;metric values
G90 ;absolute positioning
M82 ;absolute extrusion mode
G28 X0 Y0 ;домой по Х и У
G28 Z0 ;домой по Z
G92 E0 ;сбросить счетчик экструдера
G1 F1800 E+3 ;выдавить 3мм пластика
G0 X4 Y4 Z0.3 F3600 ;переместить сопло на координату
G1 Y150 E15 F200 ;напечатать линию до 150мм
G92 E1 ;установить счетчик экструдера на 1мм
G1 F1800 E-1 ;откатить 1мм пластика
G1 Z5.0 F3000 ;поднять сопло на 5мм
