KarenGhardashyan/scissor-mechanism-golden-rule/cad/stl/Деталь2.STL

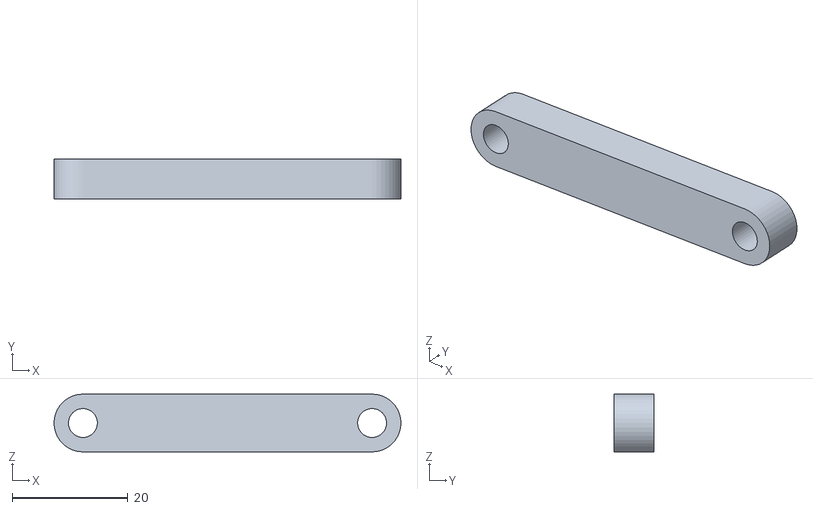
[picture p33: CAD file, 2026-10-17]
cad/stl/Деталь2.STL
60.0 x 7.00 x 10.0
