KarenGhardashyan/scissor-mechanism-golden-rule/cad/stl/Деталь1.STL

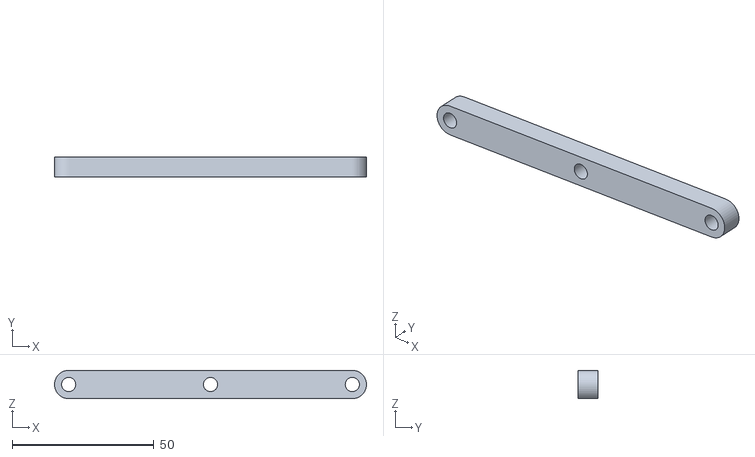
[picture p34: CAD file, 2026-10-17]
cad/stl/Деталь1.STL
110.0 x 7.00 x 10.0
