KarenGhardashyan/scissor-mechanism-golden-rule/docs/PHYSICS_MANUAL.md

# Физика ножничного пантографа: Полное академическое и инженерное руководство

> **Назначение документа:** Данное руководство содержит исчерпывающее физико-математическое описание ножничного механизма (пантографа). Оно составлено так, чтобы любой увлеченный студент, преподаватель или разработчик физических движков мог с нуля понять механику системы, построить правильные эпюры сил (Free-Body Diagrams) и реализовать абсолютно точную цифровую симуляцию.

---

## 1. Кинематическая схема и геометрия

Пантограф представляет собой последовательное соединение $n$ ромбических шарнирных ярусов (секций), образованных перекрестными жесткими стержнями (звеньями).

```
        O (Потолочный неподвижный шарнир)
       / \
      /   \    Стержень длины 2b
     /     \
    A-------A' (Боковые шарниры яруса 1)
     \     /
      \   /
       \ /
        C_1    (Центральный промежуточный шарнир)
       / \
      /   \
     /     \
    B-------B' (Боковые шарниры яруса 2)
       ...
        M      (Подвешенный груз внизу)
```

### Параметры одного стержня (балки):
- В реальном механизме балки перекрестий **сплошные (цельные)**. Они соединяются в центральной точке $C_i$ сквозным шарниром и работают как **двуплечий рычаг (качели)**.
- Полная длина балки: $L_{\text{arm}} = 2b$.
- Центральный шарнир делит балку ровно пополам: плечо каждого полузвена равно $b$.
- Масса одной балки: $m_{\text{link}}$. В одном ярусе 2 перекрестные балки (4 полузвена).

### Угловые и линейные соотношения:
Пусть $\theta$ — угол наклона полузвена к горизонтальной плоскости ($0 < \theta < 90^\circ$):

1. **Высота одного яруса (вертикальная диагональ ромба):**
   $$H = 2b \sin\theta$$
2. **Ширина яруса (горизонтальная диагональ ромба):**
   $$W = 2b \cos\theta$$
3. **Полная вертикальная длина механизма из $n$ ярусов:**
   $$L = n \cdot H = 2n b \sin\theta$$
4. **Связь вариаций перемещений (виртуальные перемещения):**
   $$dH = 2b \cos\theta \, d\theta$$
   $$dW = -2b \sin\theta \, d\theta = -\tan\theta \, dH$$
   $$dL = n \, dH$$

> [!IMPORTANT]
> **Кинематическое передаточное число:**
> Вертикальное перемещение нижнего груза ровно в $n$ раз больше перемещения одного верхнего яруса:
> $$\frac{dL}{dH} = n, \quad v_{\text{груза}} = n \cdot v_{\text{яруса}}$$
> При сжатии механизма по вертикали ($dH < 0$) его боковые шарниры раздвигаются по горизонтали ($dW > 0$).

---

## 2. Золотое правило механики (Принцип виртуальной работы)

Рассмотрим идеальный механизм без трения, находящийся в статическом равновесии:
- Снизу подвешен груз $M$, создающий силу тяжести $P = M \cdot g$.
- Сверху к первому ярусу приложена удерживающая сила $F_{\text{in}}$ (например, от пружины, уравновешивающей груз вдоль координаты $H$).

По принципу возможных перемещений Даламбера — Лагранжа сумма элементарных работ всех активных сил на любом возможном перемещении равна нулю:
$$\delta A = 0 \implies F_{\text{in}} \cdot \delta H - P \cdot \delta L = 0$$

Подставляя $\delta L = n \, \delta H$:
$$F_{\text{in}} \cdot \delta H - P \cdot (n \, \delta H) = 0 \implies F_{\text{in}} = n \cdot P$$

> [!NOTE]
> **Фундаментальный вывод Золотого правила механики:**
> Выигрывая в перемещении в $n$ раз ($L = n H$), мы ровно в $n$ раз проигрываем в силе ($F_{\text{in}} = n P$). 
> Верхняя пружина или привод обязаны развивать силу, в $n$ раз превышающую вес подвешенного груза!

---

## 3. Силовой анализ методом сечений (Free-Body Diagram)

Чтобы понять, какие силы действуют на каждый отдельный брусок и шарнир, применим **метод мысленных сечений**.

### А. Сечение по ярусу $k$ (считаем сверху вниз: $k = 1, 2, \dots, n$)
Рассечем механизм горизонтальной плоскостью через боковые шарниры яруса $k$. Отбросим нижнюю часть и заменим ее действие силами в стержнях.

1. **Какой вес висит ниже яруса $k$?**
   Ниже яруса $k$ находится $(n - k)$ полных ярусов плюс груз $M$.
   Суммарный передаваемый вертикальный вес $P_k$:
   $$P_k = M \cdot g + (n - k) \cdot (2 m_{\text{link}}) \cdot g + m_{\text{link}} \cdot g$$
   *(где $2 m_{\text{link}}$ — масса двух звеньев каждого нижнего яруса).*

2. **Равновесие отсеченной части:**
   Вертикальную нагрузку $P_k$ несут ровно **два** симметричных стержня яруса (левый и правый).
   В силу симметрии каждый стержень воспринимает ровно половину вертикальной нагрузки:
   $$F_{y,k} = \frac{P_k}{2}$$

3. **Продольное усилие в полузвене:**
   Линия действия внутренней силы $S_k$ совпадает с геометрической осью наклонного звена (под углом $\theta$ к горизонтали):
   $$S_k \cdot \sin\theta = F_{y,k} = \frac{P_k}{2} \implies S_k = \frac{P_k}{2 \sin\theta}$$

4. **Горизонтальная сила распора (Thrust Force $F_x$):**
   Проекция усилия звена на горизонтальную ось:
   $$F_{x,k} = S_k \cdot \cos\theta = \frac{P_k \cos\theta}{2 \sin\theta} = \frac{P_k}{2 \tan\theta}$$

> [!WARNING]
> **Эффект расклинивания (Toggle Effect):**
> Обратите внимание на знаменатель $\tan\theta$. Когда ножницы почти полностью сложены (горизонтальны, $\theta \to 0$), $\tan\theta \to 0$, и горизонтальное распирающее усилие $F_x \to \infty$!
> Именно поэтому в сложенном состоянии ножничные подъемники испытывают гигантские распирающие нагрузки на шарниры.

---

## 4. Разрешение Ловушки №1: Равновесие бокового шарнира и принцип двуплечего рычага

### В чём заключалась ловушка?
Если наивно предположить, что в левом боковом шарнире оба стержня тянут вправо к центру:
- Верхний тянет вправо-вверх ($\nearrow$, $+F_x, +F_y$).
- Нижний тянет вправо-вниз ($\searrow$, $+F_x, -F_y$).
То по вертикали силы взаимно уничтожатся: $\sum F_y = +F_y - F_y = 0$.
**Но по горизонтали:** $\sum F_x = +F_x + F_x = 2 F_x \neq 0$!
Шарнир обязан был бы с огромным ускорением схлопываться к центру.

### Физическая истина: Балки как двуплечие рычаги
В реальном пантографе стержни перекрестья — **цельные балки**, вращающиеся вокруг центрального пальца $C_i$:
1. Балка «1» идет из верхнего правого угла через центральный шарнир $C$ в нижний левый шарнир $A$.
2. Балка «2» идет из верхнего левого угла $A$ через центральный шарнир $C$ в нижний правый угол.
3. Центральный шарнир $C$ служит **точкой опоры (фулькрумом)** рычага-качелей.

Когда нижний груз тянет конструкцию вниз, через центральный шарнир-рычаг:
- Одно плечо балки в шарнире $A$ находится в **растяжении** (тянет шарнир к центру $\nearrow$).
- Сопряженное плечо встречной балки в том же шарнире $A$ находится в **сжатии** (упирается и толкает шарнир от центра $\swarrow$).

### Равновесие соединительного пальца (Pin FBD):
Сам шарнирный палец (металлический штифт) соединяет концы этих двух балок. Поскольку масса самого пальца пренебрежимо мала ($m_{\text{pin}} \approx 0$), по **Первому и Третьему законам Ньютона** сумма сил, действующих на палец от обеих балок, обязана быть **строго равна нулю**:

$$\vec{R}_{\text{балка 1} \to \text{палец}} + \vec{R}_{\text{балка 2} \to \text{палец}} = \vec{0}$$
$$\vec{R}_{\text{балка 2}} = -\vec{R}_{\text{балка 1}}$$

```
                       ^  R_верх (тянет к центру-вверх)
                      /
                     /
            <-------( O )-------> 
                   /   |
                  /    |
                 v     v  R_низ (толкает от центра-вниз)
               -R_верх
```

> [!IMPORTANT]
> **Итог по боковым узлам:**
> Сила взаимодействия между балками передается через палец. Если верхняя балка действует на палец силой $\vec{R} = (+F_x, +F_y)$, то нижняя балка действует на этот же палец реакцией $\vec{R}' = (-F_x, -F_y)$.
> **Векторная сумма сил на пальце строго равна нулю: $\sum \vec{F} = \vec{0}$. Шарнир находится в идеальном покое!**

---

## 5. Разрешение Ловушки №2: Физика трения в шарнирах

Необходимо строго разделять **два разных физических взгляда** на силу трения:

### Взгляд А: Обобщенная сила трения узла (Кинематический вид для учащихся)
- Боковой шарнир при сжатии и разжатии пантографа перемещается преимущественно **по горизонтали** (вдоль оси $X$).
- Вся совокупность моментов сухого трения во всех шарнирах яруса приводит к обобщенной силе сопротивления перемещению узла (Generalized Friction Force):
  $$F_{\text{fric, node}} = \tau_{\text{total}} \cdot \left| \frac{d\theta}{dW} \right|$$
- Эта сила направлена **строго горизонтально (вдоль оси $X$)**, противоположно вектору скорости схождения/расхождения узла $v_x$.
- **Для школьников и студентов это самый наглядный и понятный вид:** сразу видно, какая сила сопротивляется складыванию ромба!

### Взгляд Б: Метод сечений для отдельной балки (Контактный вид)
- Внутри цилиндрического пальца радиуса $r_{\text{pin}}$ контактное усилие $R$ создает поверхностную силу трения $F_{\text{contact}} = \mu \cdot R$.
- На радиусе пальца возникает крутящий момент:
  $$\tau_{\text{pin}} = \mu \cdot R \cdot r_{\text{pin}}$$
- Если этот момент пересчитать в поперечную силу, действующую на плече балки длины $b$, мы получаем поперечную силу:
  $$f_{\text{perp}} = \frac{\tau_{\text{pin}}}{b} = \mu \cdot R \cdot \left(\frac{r_{\text{pin}}}{b}\right)$$
- **Обратите внимание на масштабный коэффициент $\frac{r_{\text{pin}}}{b}$:**
  При радиусе пальца $r_{\text{pin}} = 3\text{ мм}$ и длине полузвена $b = 100\text{ мм}$, отношение $\frac{r_{\text{pin}}}{b} = 0.03$. 
  Поперечная сила трения на конце балки в **33 раза меньше** контактной силы Кулона $\mu R$!
  *(Если не учитывать отношение $\frac{r_{\text{pin}}}{b}$, стрелка трения оказывается нереалистично гигантской).*

---

## 6. Зона застоя (Stiction Deadband)

Из-за сухого трения механизм останавливается не точно в идеальной точке равновесия $H_0$, а застревает в диапазоне:
$$H \in [H_0 - \Delta H_{\text{stick}}, \, H_0 + \Delta H_{\text{stick}}]$$
где $\Delta H_{\text{stick}} = \frac{n \cdot \mu_s \cdot R \cdot r_{\text{pin}}}{k \cdot b \cos\theta}$.

Внутри этой зоны сила упругости пружины и сила тяжести не могут преодолеть силу сухого трения покоя $F_s$, и механизм сохраняет неподвижность.

---

## 7. Динамические уравнения движения и закон инерции $n^2 M$

Для создания полноценной физической симуляции используется уравнение Лагранжа 2-го рода:
$$\frac{d}{dt}\left(\frac{\partial T}{\partial \dot{H}}\right) - \frac{\partial T}{\partial H} = Q_{\text{пот}} + Q_{\text{дисс}} + Q_{\text{тр}}$$

### Бриллиант динамики пантографа: Приведенная масса $n^2 M$
Кинетическая энергия складывается из энергии груза и энергии звеньев:
$$T = \frac{1}{2} M \dot{L}^2 + \sum_{\text{звенья}} T_{\text{link}}$$
Так как $\dot{L} = n \dot{H}$:
$$T_{\text{груз}} = \frac{1}{2} M (n \dot{H})^2 = \frac{1}{2} (n^2 M) \dot{H}^2$$

> [!TIP]
> **Приведенная инерция:**
> Подвешенный внизу груз $M$ дает вклад в инерцию механизма, равный **$n^2 \cdot M$**!
> - Для $n = 3$ ярусов инерция возрастает в $3^2 = 9$ раз!
> - Для $n = 5$ ярусов инерция возрастает в $5^2 = 25$ раз!
> Это математически строго доказывает, почему многоярусные пантографы имеют значительно более низкую собственную частоту колебаний и колеблются плавнее и дольше!

---

## 8. Итоговая сводка для цифровой симуляции

1. **Баланс шарнирного пальца:** 
   Отображение двух противоположных реакций $\vec{R}_1$ и $\vec{R}_2 = -\vec{R}_1$, наглядно демонстрирующих $\sum \vec{F} = 0$.
2. **Сила трения $f_s$:** 
   Отображение обобщенной горизонтальной силы $F_{\text{fric, node}}$, препятствующей схождению/расхождению узлов яруса.
3. **Метод сечений:** 
   Учет распределенной массы звеньев $P_k = M g + \sum m_{\text{links}} g$.
4. **Масштабирование:** 
   Использование системного фактора масштаба контента (`content_scale_factor`) для пропорционального интерфейса на мобильных устройствах с высоким DPI.
