KarenGhardashyan/scissor-mechanism-golden-rule/experimental_data/rubber_band_measurements.csv

# Physical Experiment Data: Scissor Pantograph (n = 5 stages) with Rubber Elastic Element
# Author: Karen Ghardashyan (A. Shahinyan Phys-Math Special School)
# Date: 2025
# Apparatus: 3D-Printed PLA Scissor Linkages (l_arm = 6 cm) | Rubber Band (Non-linear hyperelasticity | 3rd-order polynomial regression)
mass_g | mass_kg | L_cm | H_cm | lambda_ratio
0 | 0.00 | 17.4 | 3.5 | 4.97
100 | 0.10 | 23.3 | 4.7 | 4.96
200 | 0.20 | 25.5 | 5.0 | 5.10
300 | 0.30 | 28.4 | 5.7 | 4.98
400 | 0.40 | 36.5 | 7.0 | 5.21
500 | 0.50 | 38.7 | 8.0 | 4.84
600 | 0.60 | 41.5 | 8.5 | 4.88
700 | 0.70 | 43.5 | 8.8 | 4.94
800 | 0.80 | 44.5 | 9.3 | 4.78
