KarenGhardashyan/scissor-mechanism-golden-rule/(commit log)

2026-10-10 Add full academic research documentation, real experimental CSV data, CAD specs, and updated README
2026-10-12 feat(ui): Add bold black-badge 3D laser labels and interactive modal window for physics formulas
2026-10-12 fix(script): Fix duplicate blue_accent variable declaration, add bold laser badges and formulas modal
2026-10-12 feat(physics): Bold black text outline on lasers, enable oscillations by default, damping slider 0-0.60
2026-10-12 docs: Add CAD engineering journey, 3D printing troubleshooting matrix, timeline trajectory, and top-tier university recommendations
2026-10-14 feat: enhance 3D force vectors visibility, anti-glare bloom, integrated joint inspector tab, and responsive mobile UI
2026-10-14 refactor(physics,ui): mechatronics simulation engineering audit and code remediation
    - Kinematics & Dynamics: rigorous Newton-Euler & Virtual Work balance with epsilon guards (theta in [3 deg, 87 deg]), dynamic Coulomb friction vector and pin resistance torque opposing joint velocity.
    - Integrator: 400Hz Symplectic Euler dynamic substep loop conserving energy at zeta=0 and stable for k >= 2000 N/m.
    - Camera & Framing: responsive aspect ratio auto-framing clamps, FOV 54 deg, default distance 6.85m eliminating Rig C occlusion.
    - Realtime Graph: zero-allocation WebGL buffers, lerp mass scrubbing, exact curves for lambda=3, 5, 6.
    - Typography & Theme: thick contrast outlines on in-world 3D label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
2026-10-14 feat(mobile): adapt UI to mobile phones with slide-out sidebar, touch camera gestures, and direct pin picking
    - Slide-out Sidebar Drawer with 4 smooth scrollable tabs: Controls, Telemetry, Joint Inspector, and Curves.
    - Sleek Mobile Top Bar with 'Menu', quick camera focus pills ('All', 'A', 'C', 'B'), theme toggle, and view reset.
    - Mobile multi-touch camera: single-finger orbit, two-finger pinch-to-zoom and two-finger pan.
    - Touch raycasting with 32cm threshold for accurate 1-tap joint pin selection on mobile touchscreens.
    - Floating bottom pin chip displaying selected joint summary with 1-tap 'Details' opening Joint tab.
    - Quick direct pin selector buttons inside Joint tab for fast inspect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
2026-10-14 fix(mobile): dynamic viewport scaling for touch targets, buttons, fonts, and cache-busting
    - Implemented dynamic mobile scale multiplier S = clampf(vp_size.x / 400.0, 1.0, 4.5) to account for Godot canvas_items 1600px portrait expand mode
    - Scaled Mobile Top Bar height, Menu button, focus pills (All, A, C, B), theme and reset icons to 44dp+ physical touch targets
    - Expanded Slide-Out Sidebar drawer width to 88% screen width with scalable fonts (18pt titles, 14pt body, 13pt badges)
    - Scaled all sidebar controls (thick 44dp sliders, planet preset buttons, impulse kick, direct pin selector buttons)
    - Updated LiveGraph with ui_scale rendering and touchscreen drag/touch gesture input
    - Added cach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
2026-10-16 feat(physics): Velocity Verlet oscillation, square-root vector scaling, and two-tier inspector UX
2026-10-16 fix(visual): enforce unsigned 3D labels, fix friction orientation, eliminate label collisions, enhance light theme, and re-frame camera
2026-10-16 fix(physics): tune natural oscillation with distributed linkage inertia, clamp 1.2-2.2Hz, separate Z vectors, and polish light theme
2026-10-16 feat(joint-inspector): zero static friction, vector mode toggle (All vs R), and Upper/Down force perspective toggle
2026-10-16 fix(ui): scale icons down to 0.5 size without expansion, enlarge mobile mass slider track and tactile 28px grabber knob
2026-10-16 feat(physics): variable joint friction system with zero-friction mode, presets, and 3D force vectors
2026-10-16 feat(physics): implement physical Coulomb stiction deadband, bidirectional static holding vectors, and joint telemetry lock indicator
2026-10-16 feat(physics): add toggle button for static friction (stiction deadband) to compare real vs theoretical glide
2026-10-16 feat(physics-graph): separate kinetic drag from stiction threshold, add rig filtering with linear regression and stiction envelope
2026-10-17 feat: spring force vector visualizer, matte studio materials & CAD media integration
    - Add 3D spring force vector (F_spr, purple) showing direction and magnitude pulling each joint/pin
    - Integrate CAD files: STL meshes, Ultimaker Cura G-code toolpaths, start/end scripts, and SolidWorks screenshots in cad/
    - Update PantographRig and Main with matte studio gray PBR materials, eliminating neon glare, bloom, and SSR dithering
    - Update Joint Inspector telemetry with real-time Spring Tension row
    - Update README.md and cad/README.md with hardware, CAD, and advanced physics documentation
    - Export web build with updated cache-buster and preserved KaTeX modal
2026-10-17 Revert "feat: spring force vector visualizer, matte studio materials & CAD media integration"
    This reverts commit 2cad03ab1cf2019bbcb4719a69d38b7fd6efb001.
2026-10-17 style: halve spring radius, soft-glow slate materials for spring and mass, remove side pillars
2026-10-17 feat: add header play/pause button and simulation speed slider (Option B)
2026-10-17 fix(mobile): delta multi-touch camera with bounded safety clamp and enlarged UI ergonomics
2026-10-17 fix(mobile): full-screen 3D framing, touch-first large buttons and sliders, removed zoom obstruction
2026-10-17 fix(mobile): double touch scale for buttons, tabs, peek bar and massive thumb-friendly sliders
2026-10-17 fix(mobile): remove manual pixel multiplier scaling, fix camera distance to 3.6m and stabilize two-finger gestures
2026-10-21 fix(vectors, cache): bind label font color directly to arrow material and purge browser service-worker cache
2026-10-21 fix(physics, vectors): clean physical derivation of Rup from spring and Rdown from load, collinear vectors along beam, fs static holding balance
2026-10-21 Display static friction threshold fs_max = mu * R_down in Joint HUD card
2026-10-21 Update README with comprehensive joint vector mechanics, stiction physics, pedagogical guide, and latest simulation screenshot
2026-11-09 docs: organize assembly figures into 2x2 grid and update Coulomb stiction holding GIF
2026-11-09 docs: update Figure 5 with close-up photo of dual jam nut pivot assembly on test rig
2026-11-10 feat(web): add responsive mobile device warning modal with continue/exit options
2026-11-10 fix(ui,camera): remove tofu glyphs, fix Upper/Lower force vector toggles, and add laptop trackpad/keyboard navigation
2026-11-10 build(web): re-export Godot Web package and document full camera controls in README
2026-11-10 fix(script,web): resolve Parse Error current_rig_id in Main.gd and update web package
